ayusharma17/ECE-455-Magnetometer-3/LTSpice/pyppm_12v_ltspice_starter (1)/pyppm_polarizer_waveforms.png

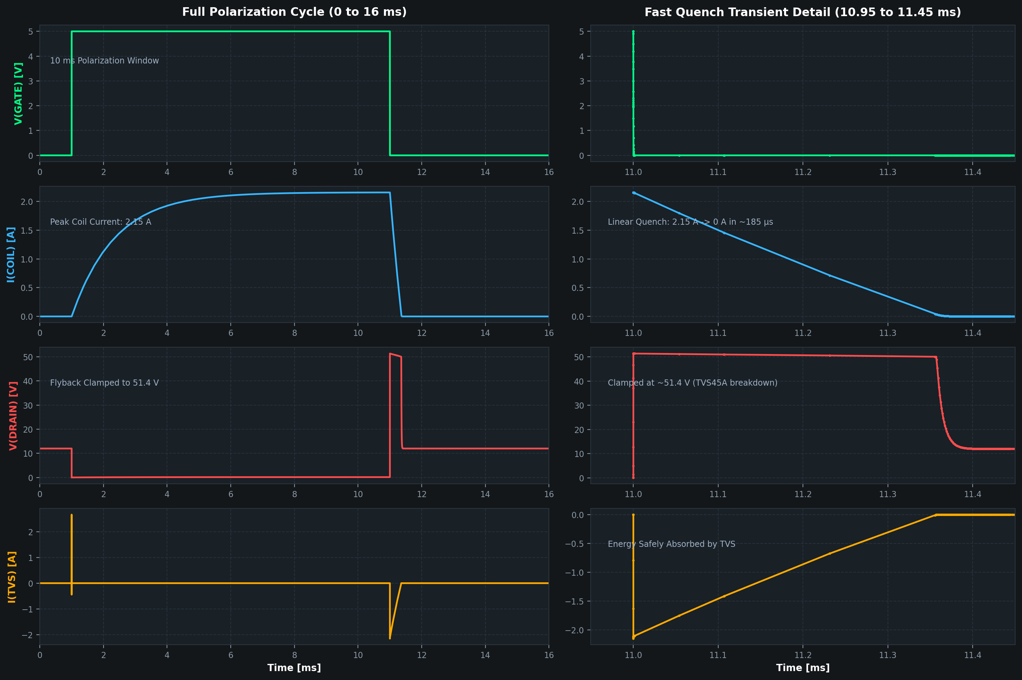
LTSpice/pyppm_12v_ltspice_starter (1)/pyppm_polarizer_waveforms.png
