ayusharma17/ECE-455-Magnetometer-3/LTSpice/relay_circuit/relay_circuit_waveforms.png

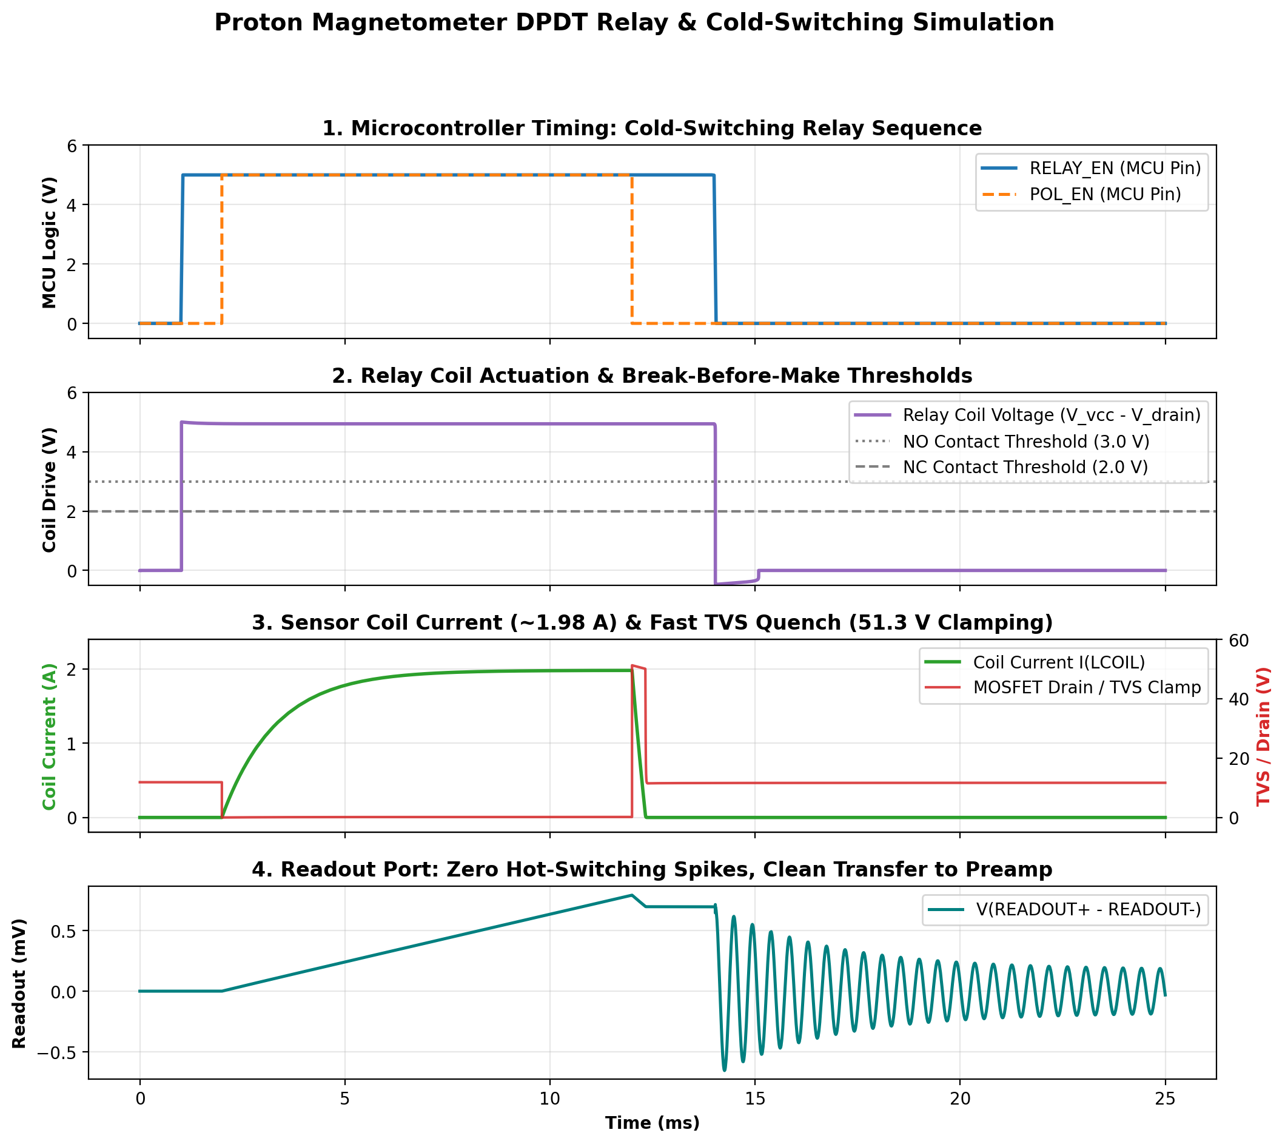
LTSpice/relay_circuit/relay_circuit_waveforms.png
