ayusharma17/ECE-455-Magnetometer-3/plans/pyppm_polarization_page12.png

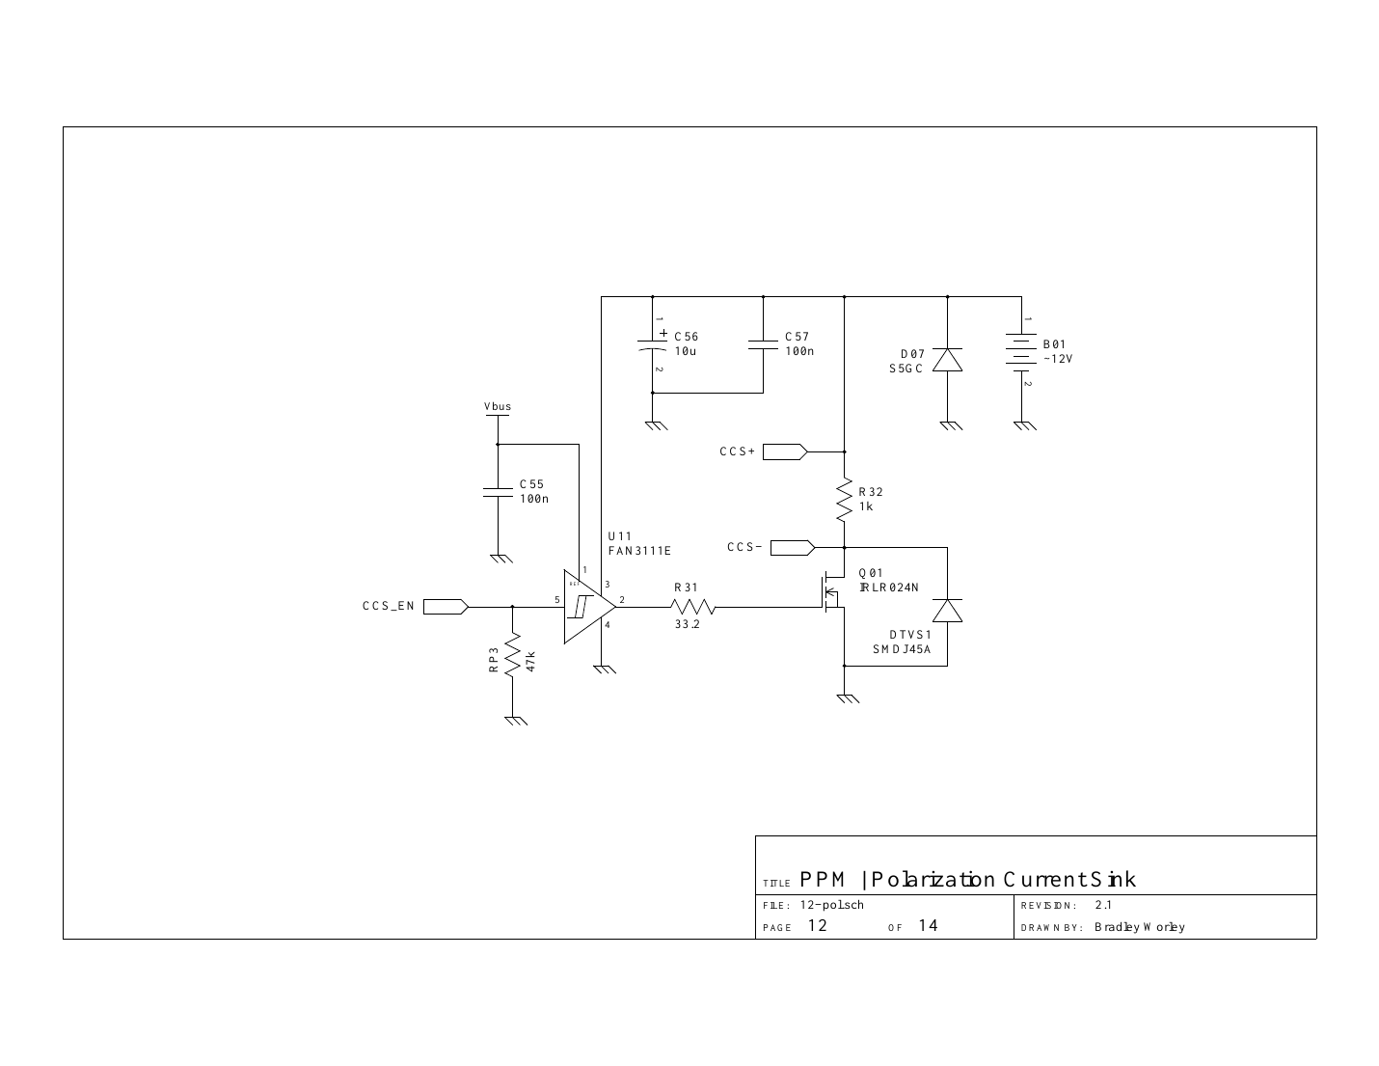
plans/pyppm_polarization_page12.png
