ayusharma17/ECE-455-Magnetometer-3/simulation/proton_precession_demo_results.png

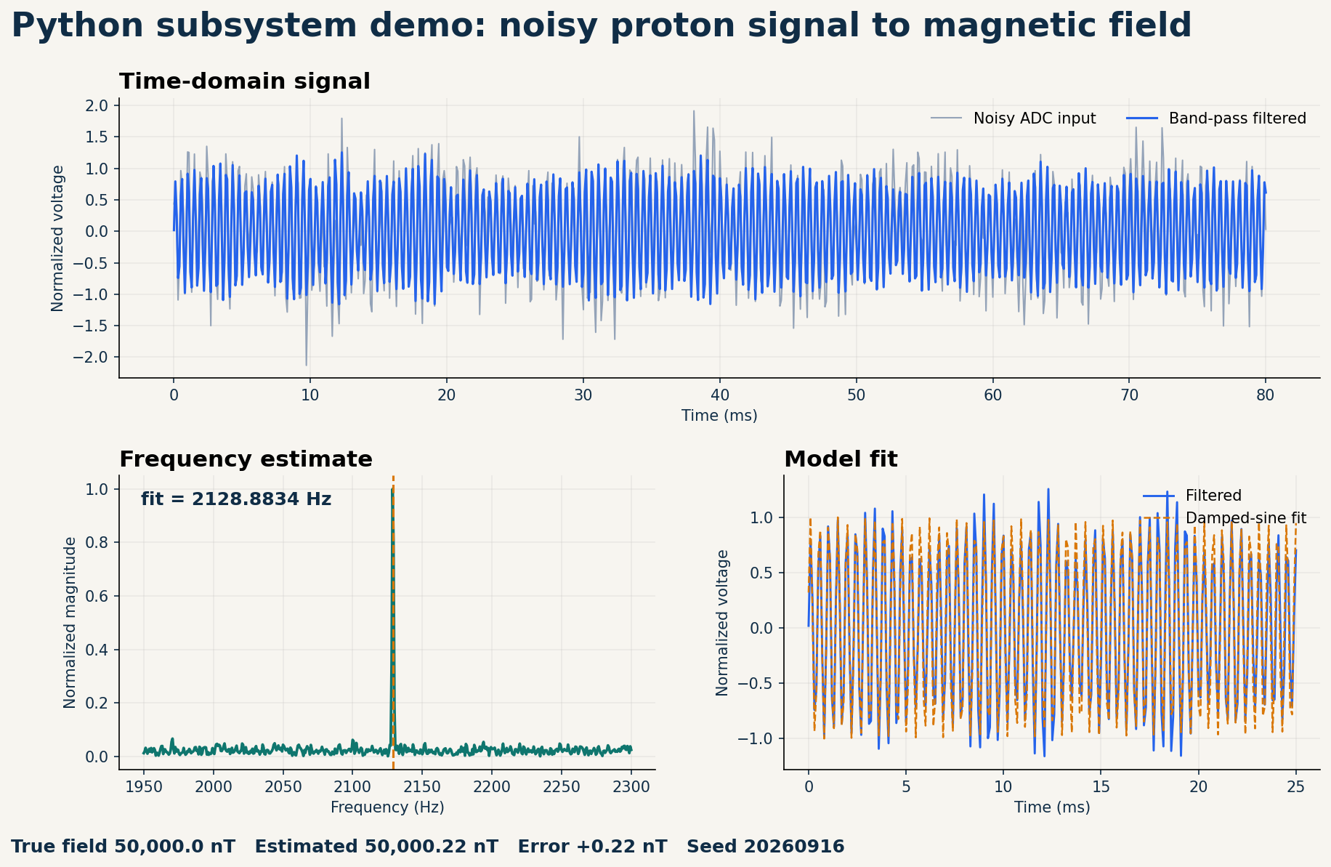
simulation/proton_precession_demo_results.png
