ayusharma17/ECE-455-Magnetometer-3/LTSpice/pyppm_12v_ltspice_starter (1)/pyppm_12v_polarizer_graphical.asc

C56: cap; 10u
C57: cap; 100n
D07: diode; DPOWER
DTVS1: zener; TVS45A
LCOIL: ind; 7.5m
M01: nmos; QSIM
R31: res; 33.2
R32: res; 1k
RCOIL: res; 5.5
VBAT: voltage; 12
VDRIVE: voltage; PULSE(0 5 1m 50n 50n 10m 20m)
Named nets: CCS_PLUS, CCS_MINUS, 0, GATE
.tran 0 16m 0 1u
.model QSIM NMOS(VTO=2 KP=5 LAMBDA=0.01 RD=5m RS=5m CGSO=0.3n CGDO=0.2n)
.model TVS45A D(Is=1n Rs=0.55 N=1 BV=50 IBV=1m Cjo=2n)
.model DPOWER D(Is=10n Rs=0.05 N=1.5 BV=100 IBV=10u)
.meas TRAN I_COIL_MAX MAX I(LCOIL)
.meas TRAN V_DRAIN_MAX MAX V(CCS_MINUS)
.meas TRAN T_QUENCH TRIG I(LCOIL) VAL=1 FALL=1 TARG I(LCOIL) VAL=0.01 FALL=1
