ayusharma17/ECE-455-Magnetometer-3/(commit log)

2026-09-15 Initial proton magnetometer design
2026-09-16 Clarify polarization power-stage design
2026-09-18 Add polarization circuit reference documentation
2026-09-23 Fix LTspice polarization circuit schematic layout and overlap issues
2026-09-29 Design measuring circuit and relay front-end with verified LTspice simulations
2026-09-30 Fix complete-system relay and noise simulation notes
2026-09-30 Add relay and measurement circuit progress deck
2026-09-30 Create relay-only progress deck
2026-09-30 Remove amplifier and filter circuit and retain relay documentation
2026-09-30 Add standalone relay and cold-switching simulation
